DrOnkel/PopUpMap/README.md

# PopUpMap
Interactive maps for visually impaired
