DrOnkel/PopUpMap/East.stl

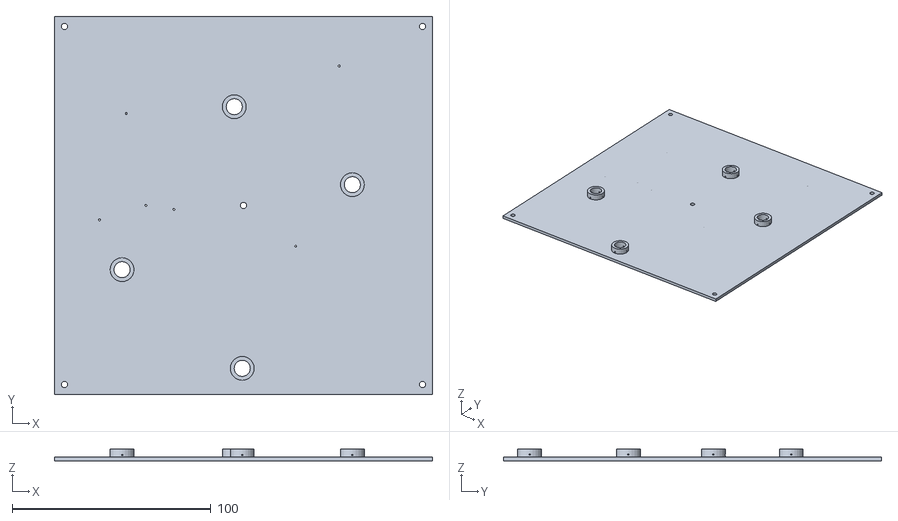
[picture p12: CAD file, 2020-08-01]
East.stl
190.0 x 190.0 x 6.00
