DrOnkel/PopUpMap/BSide.stl

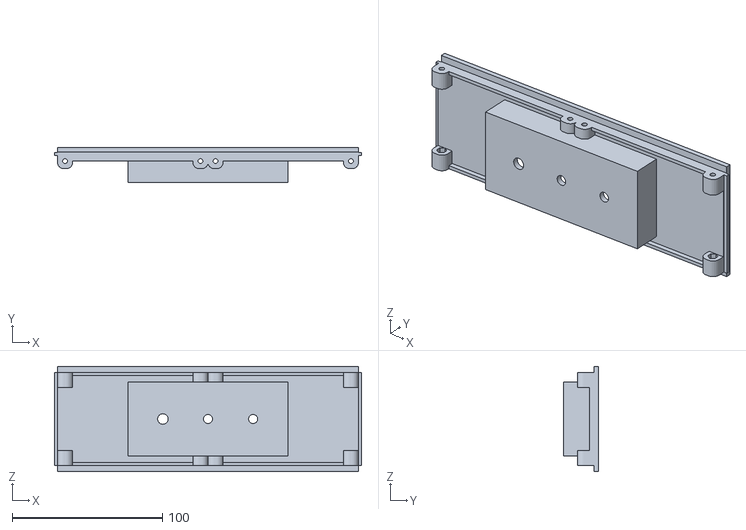
[picture p13: CAD file, 2020-08-01]
BSide.stl
204.0 x 23.2 x 70.0
