DrOnkel/PopUpMap/BottomLeft.stl

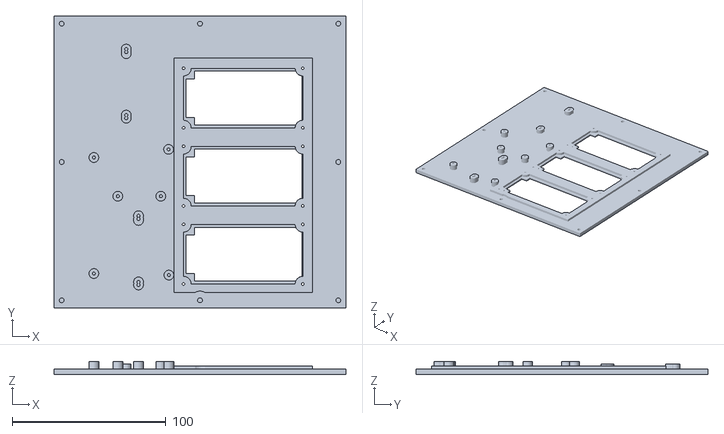
[picture p14: CAD file, 2020-08-01]
BottomLeft.stl
190.0 x 190.0 x 8.50
