DrOnkel/PopUpMap/BottomRight.stl

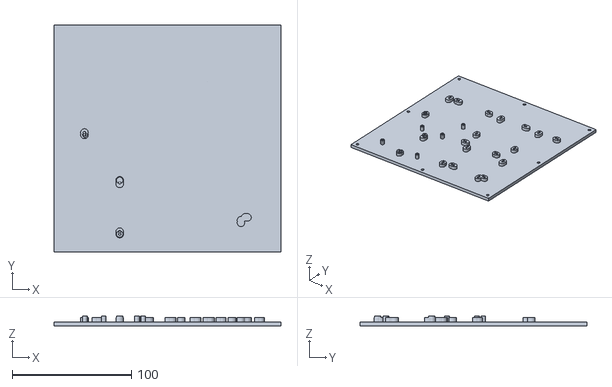
[picture p15: CAD file, 2020-08-01]
BottomRight.stl
190.0 x 190.0 x 8.50
