DrOnkel/PopUpMap/LeftSide.stl

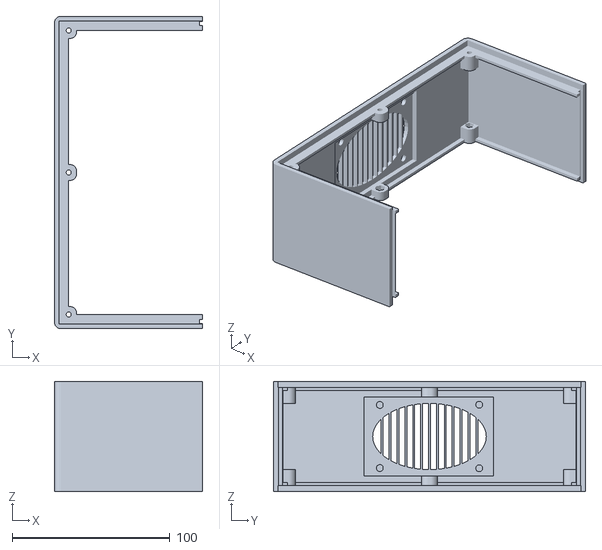
[picture p16: CAD file, 2020-08-01]
LeftSide.stl
93.8 x 198.0 x 70.0
