DrOnkel/PopUpMap/FSide.stl

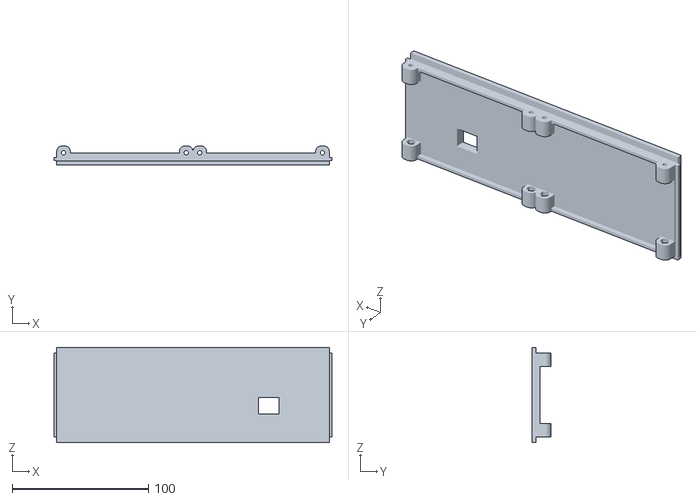
[picture p17: CAD file, 2020-08-01]
FSide.stl
204.0 x 14.0 x 70.0
