DrOnkel/PopUpMap/SensorBox.stl

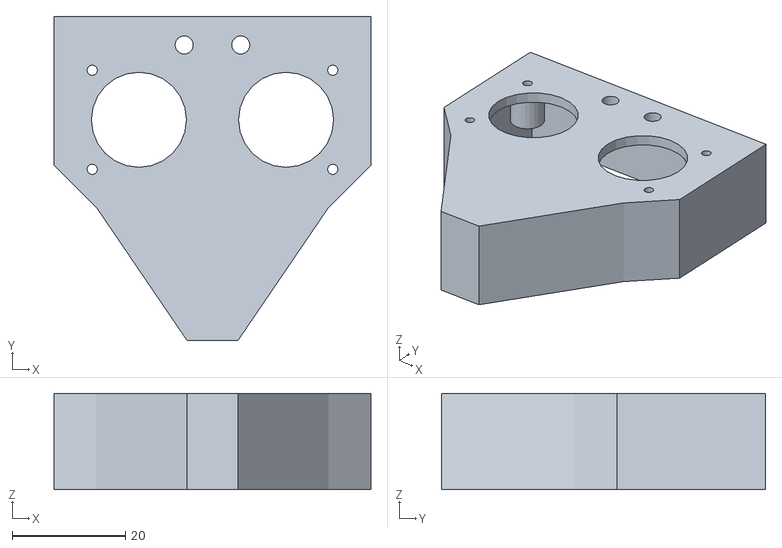
[picture p18: CAD file, 2020-08-01]
SensorBox.stl
56.0 x 57.2 x 17.0
