DrOnkel/PopUpMap/EastMagnet.stl

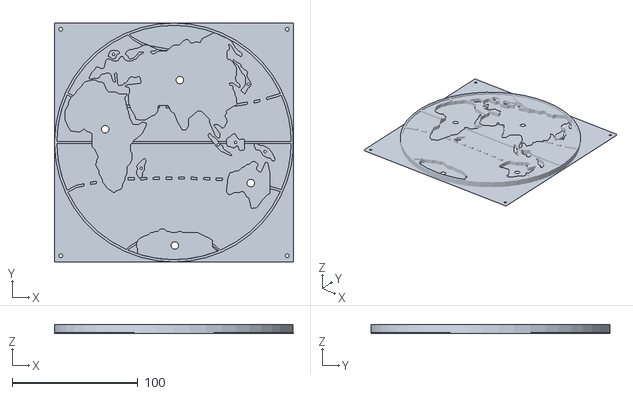
[picture p19: CAD file, 2020-08-01]
EastMagnet.stl
190.0 x 190.0 x 6.80
