DrOnkel/PopUpMap/WestMagnet.stl

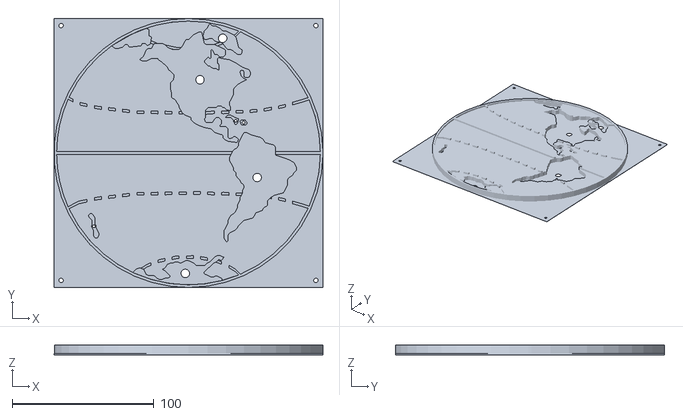
[picture p20: CAD file, 2020-08-01]
WestMagnet.stl
190.0 x 190.0 x 6.80
