DrOnkel/PopUpMap/SemEast.stl

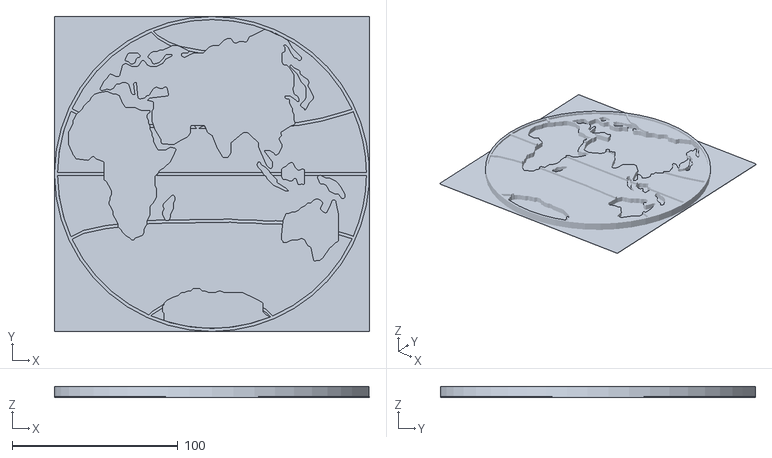
[picture p21: CAD file, 2020-07-24]
SemEast.stl
190.0 x 190.0 x 6.80
