DrOnkel/PopUpMap/V1_NorthAm.stl

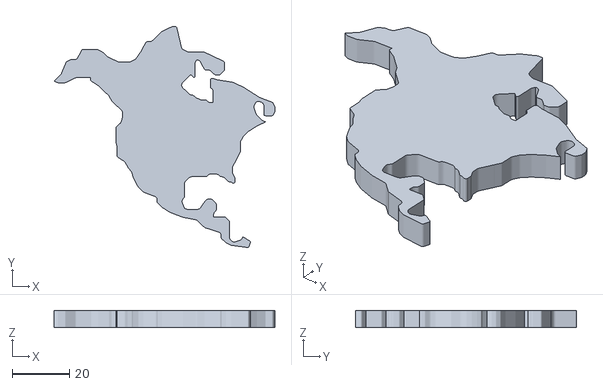
[picture p22: CAD file, 2020-07-22]
V1_NorthAm.stl
77.2 x 77.2 x 6.00
