DrOnkel/PopUpMap/V1_Eurasia.stl

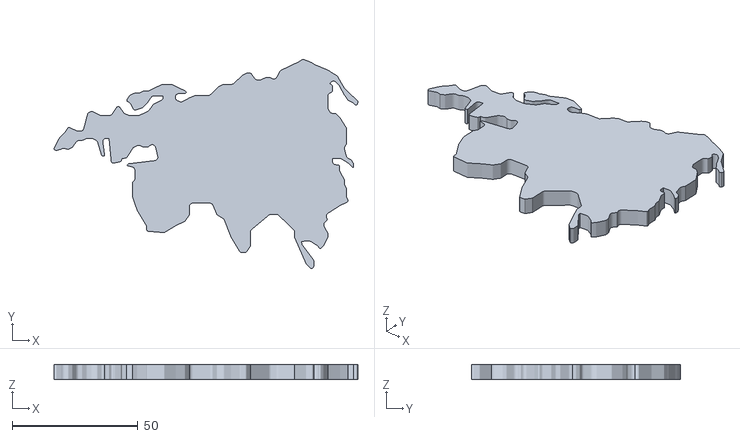
[picture p23: CAD file, 2020-07-22]
V1_Eurasia.stl
120.8 x 83.1 x 6.00
