DrOnkel/PopUpMap/V1_Other.stl

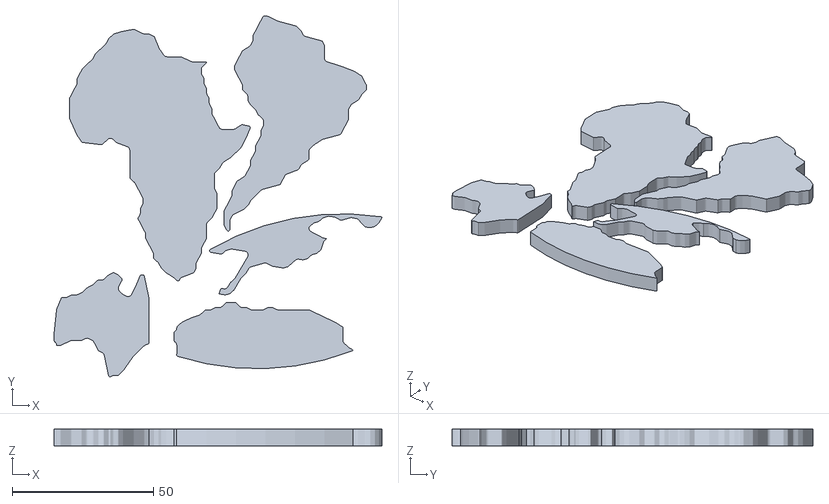
[picture p24: CAD file, 2020-07-22]
V1_Other.stl
116.2 x 127.7 x 6.00
