DrOnkel/PopUpMap/V1_Islands.stl

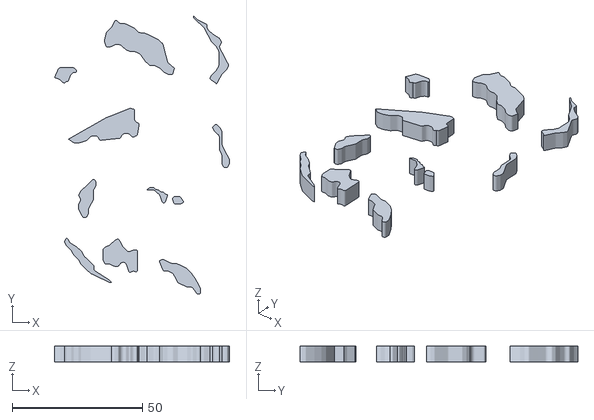
[picture p25: CAD file, 2020-07-22]
V1_Islands.stl
67.2 x 106.8 x 6.00
