DrOnkel/PopUpMap/(list of files, cad)

Other CAD files:
West.stl
RightSide.stl
SemWest.stl
